naeemsadik/MicroProject/autonomous_rover/maps/floorplan.png

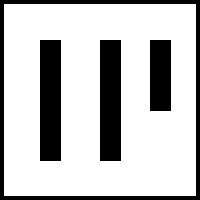
autonomous_rover/maps/floorplan.png
