naeemsadik/MicroProject/(commit log)

2026-06-16 feat: Implement core functionality for autonomous rover
    - Added ArUco marker localization in `localization.py` for pose estimation.
    - Created `main.py` to serve as the entry point for the mission controller.
    - Developed `map_processor.py` to generate occupancy grids from images.
    - Introduced `mission_controller.py` to manage the rover's mission flow and navigation.
    - Implemented waypoint navigation logic in `navigator.py`.
    - Added odometry calculations in `odometry.py` for tracking rover position.
    - Created A* path planning algorithm in `planner.py`.
    - Developed QR code scanning functionality in `qr_scanner.py`.
    - Implemented virtual hardware simulation in `virtual_hardware.py`.
    - Created wa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
2026-06-16 feat: Add project documentation for pin diagram, code plan, and automation plan
2026-06-16 feat: Add updated ESP32 pin diagram and wiring details
2026-06-16 fix: Correct ultrasonic and compass pin configurations in WarehouseRobot.ino
2026-06-16 Add RPi4 Admin Panel and ESP32 integration
    - Created a new admin panel for the Raspberry Pi 4 to control the warehouse robot.
    - Implemented live camera feed, QR code detection, and telemetry display.
    - Added manual control features for robot movement and gripper actions.
    - Integrated ESP32 for serial communication and telemetry data.
    - Updated settings configuration to include admin panel parameters.
    - Enhanced WarehouseRobot.ino with WiFi capabilities and web server for admin panel.
    - Added logging functionality for better monitoring and debugging.
2026-06-16 Add warehouse rover stack: RPi4 brain, ESP32 firmware, admin panel
    - RPi4 Python stack: A* planner, waypoint navigator, differential
    odometry, serial comms, QR scanner, mission controller
    - Web admin panel (port 8080) with live camera, MJPEG, JSON status,
    map preview, and manual nudge controls
    - ESP32 firmware: L298N motors, two-servo gripper, HC-SR04 distance,
    MPU6050 yaw, line-based serial protocol
    - Warehouse map (200x200), occupancy grid, A*-based path planning,
    9-slot lookup table (R1C1..R3C3)
    - QR-code label generator, setup.sh (venv + permissions + grid + QR),
    16-test unit suite
    - Add .venv/ to .gitignore
    - Add comprehensive explain.md with pin map, component reference,
    al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
2026-06-16 Make admin panel the single entry point; add auto-drive; trim repo
    - Add POST /api/drive?action=start&slot=R1C1 to the admin panel: in
    a background thread, the panel spawns a MissionController, plans
    an A* path, and drives autonomously. Status streams to the
    /api/status JSON and to a new "Auto-drive" card on the HTML
    page. /api/drive?action=stop aborts.
    - Trim setup.sh: drop the mission/test blurb from the post-setup
    printout, since the admin panel is the only thing the user runs.
    - Drop matplotlib from requirements.txt (only used by sim, which
    is gone). qrcode/Pillow left commented for label regen.
    - Delete unused files: legacy WarehouseRobot.ino, component_tests/,
    PinDiagram.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
2026-06-17 Live map updates, warehouse length/width config, expanded admin panel
    Live map updates:
    - Add PosePublisher thread inside AutoDriver that copies
    controller.odometry.pose into admin_state.pose at 5 Hz during a
    mission. Also publish in response to /api/pose/reset.
    - Add map_version counter; bumped on every pose, QR, or waypoint
    change. The browser polls it and only re-fetches /api/map.jpg
    when it changes — saves CPU and avoids the old "stuck map" bug.
    - render_map_jpeg now draws the live pose trail (last 200 samples),
    a 10% scale bar in cm, a faint cm grid every grid_step_cm, and
    a heading arrow.
    Warehouse length/width config:
    - Add map.length_cm, map.width_cm, map.grid_step_cm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
    [admin_panel.py, settings.yaml]
2026-06-17 Fix right motor direction and add interruptible Stop to auto-drive
    The ESP32 wiring has IN3/IN4 swapped relative to IN1/IN2, so positive
    speeds were making the right wheel run backward while the left ran
    forward — the rover could only turn, never drive straight.
    Also wire a should_stop callback through MissionController._follow_waypoints
    so the auto-drive loop honors the manual Stop button within ~50 ms
    instead of waiting for the current waypoint to finish.
    [admin_panel.py, mission_controller.py, rover_firmware.ino]
2026-06-17 Fix UnboundLocalError on HOME target and Thread._stop shadowing
    Two bugs showed up when running auto-drive from the admin panel:
    1) When the slot was HOME, the if/else set ``target`` in both branches
    but the trailing ``target = destination.navigation_target`` ran
    unconditionally, referencing ``destination`` which was only defined
    in the else branch -> UnboundLocalError aborting the mission.
    2) ``PosePublisher.__init__`` assigned the stop Event to
    ``self._stop``, shadowing ``Thread._stop()``. When the auto-drive
    thread later called ``pose_publisher.join()``, Python internally
    invoked the now-overwritten ``_stop`` as a method -> TypeError:
    'Event' object is not callable.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
    [admin_panel.py]
2026-06-17 Share ESP32Interface and auto-reconnect on transient I/O errors
    Two related bugs caused the [Errno 5] Input/output error storms after
    auto-drive started:
    1) The admin panel and MissionController each opened their own
    ESP32Interface on /dev/ttyACM0. Opening a USB-CDC ACM device a
    second time resets it on Linux, which throws the ESP32 firmware
    into a brief enumeration window where reads return no data and
    writes return Errno 5. Once that happened, the admin panel's
    serial handle was wedged and every subsequent nudge / auto-drive
    command logged "write failed" forever.
    2) ESP32Interface._hardware_read_loop broke out of its loop on the
    first read exception, leaving telemetr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
    [admin_panel.py, comms.py, mission_controller.py]
2026-06-17 Make ESP32 reconnect tolerant of transient USB-CDC errors
    The previous commit's reconnect logic was too aggressive: a single
    Errno 5 read error triggered a reconnect attempt, the attempt failed
    because /dev/ttyACM0 was briefly un-enumerable, and the link was
    permanently marked closed. Every subsequent motor command silently
    dropped because send_velocity_cmd now saw simulation_mode=True and
    returned without writing -- which is why the rover stopped moving
    after the first nudge.
    This commit:
    * _open_serial no longer flips simulation_mode=True on a failed
    reconnect, only on the initial open. A device that briefly
    disappears during enumeration no longer disables the link.
    * _write_line / _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
    [comms.py]
2026-06-17 Revert "Fix right motor direction..." through "Make ESP32 reconnect tolerant..."
    This rolls back the last four commits on main:
    9aadc06 Make ESP32 reconnect tolerant of transient USB-CDC errors
    1e2f9d0 Share ESP32Interface and auto-reconnect on transient I/O errors
    e1900b3 Fix UnboundLocalError on HOME target and Thread._stop shadowing
    25cca1f Fix right motor direction and add interruptible Stop to auto-drive
    The Python admin-panel / comms / mission-controller changes caused
    the rover to stop moving (the auto-reconnect logic was too aggressive
    and silently flipped the link into simulation mode after a single
    transient USB-CDC error, which dropped every subsequent motor
    command)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
    [admin_panel.py, comms.py, mission_controller.py, rover_firmware.ino]
2026-06-17 Fix right motor direction (IN3/IN4 polarity swap)
    The ESP32 wiring has IN3/IN4 swapped relative to IN1/IN2, so a
    positive speed on both wheels made the left wheel run forward and
    the right wheel run backward — the rover could only turn in place,
    never drive straight.
    Swap the forward/reverse branches in driveRightMotor so positive
    speeds drive both wheels forward and negative speeds drive both
    backward. The Python admin panel and mission controller stay at
    their pre-revert state (commit 6fa9f23), where the rover reliably
    moves in all four directions.
    [rover_firmware.ino]
